keywish/keywish-hummer-bot-v2.0/README.md

# Please Contact Us
Technical support email: support@keywish-robot.com</br>
Sales email: ken@keywish-robot.com</br>
The latest information download address:https://github.com/keywish/keywish-hummer-bot-v2.0    </br>


# Hummer-bot 
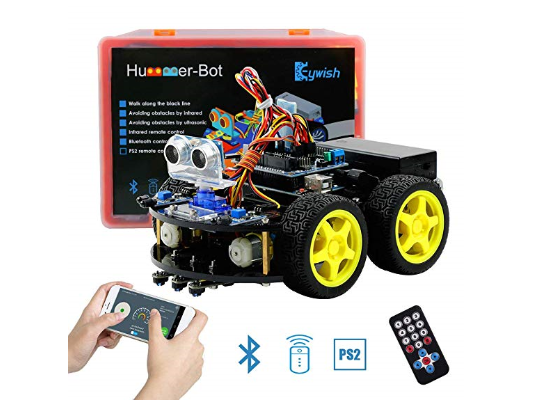
[picture p1: hummer_bot2.0.jpg]


# Introduction
Hummer-Bot is a multi-function car, it is based on the Arduino UNO and the L298N motor drive module. You can freely install various sensor modules such as servo, ultrasonic, infrared obstacle avoidance, infrared tracking, etc. It can trace and avoid obstacles automatically, and it supports multiple remote control methods: infrared remote control, Bluetooth APP, PS2 handle (optional). And we will provide CD with the best tutorial including the programs and codes which bring you to the robot car world. It is the best choice for electronics enthusiasts, makers, and Arduino enthusiasts.
# Feature
* 3-channel infrared tracking modules </br>
* 2 sets of infrared obstacle avoidance modules </br>
* ultrasonic obstacle avoidance with servo </br>
* 2-channel DC motor drive </br>
* 2 rechargeable lithium batteries:3000mZh/3.7v, longer battery life </br>
* Real-time battery power detection </br>
* Infrared remote control </br>
* Bluetooth app control </br>
* PS2 handle control (optional) </br>

# Required Best Buy Links
[Buy on Amazon]( https://www.amazon.com/dp/B07CFX53W4) </br>
[Buy on AliExpress]( https://www.aliexpress.com/store/product/Smart-Cars-for-Arduino-UNO-R3-Super-Starter-Kit-APP-RC-Remote-Control-Ultrasonic-Bluetooth-Module/3269016_32920074010.html)

# Download Method
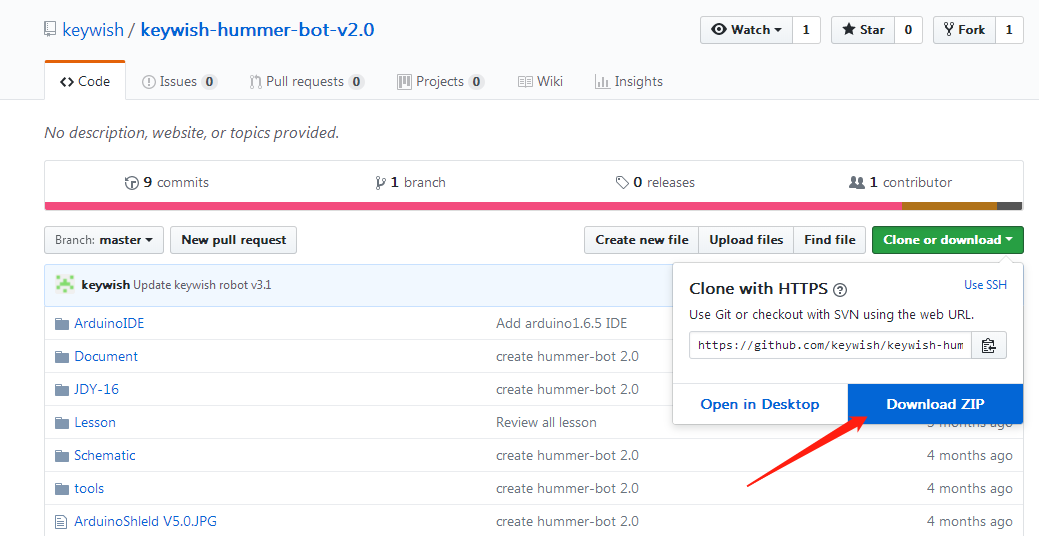
[picture p2: Download_instructions.jpg]
