keywish/keywish-hummer-bot-v2.0/Lesson/ModuleDemo/UltrasonicDemo/Ultrasonic.pdf

## Ultrasonic

## Ultrasonic ranging principle

Ultrasonic transmitter launches ultrasonic to a certain direction and we start timing at the same time. When the ultrasonic in the air runs into obstacles, it will return immediately, ultrasonic receiver receives the reflected wave, then we stop timing. Sound waves in the air are at the rate of 340 m/s, according to the recorded time t, the distance s between launch spot and the obstacles can be calculated, that is: s = 340m / s * t / 2. So we can get the distance.
Ultrasonic ranging module has four pins, they are Vcc, Trig, Echo, GND, among the Trig is distance measuring trigger pin, as long as the Trig pin are at least 10μs high level, ultrasonic sending module will automatically send eight 40KHZ ultrasonic pulse, and automatically detect whether there is a returned signal . This step will be done automatically by the inside module. If there is any returned signal, the Echo pin will output high level, the duration of the high level is the time of ultrasonic wave from launch to return. At this point, we can use pulseIn () function to obtain the result of distance measuring, and calculate the actual distance.

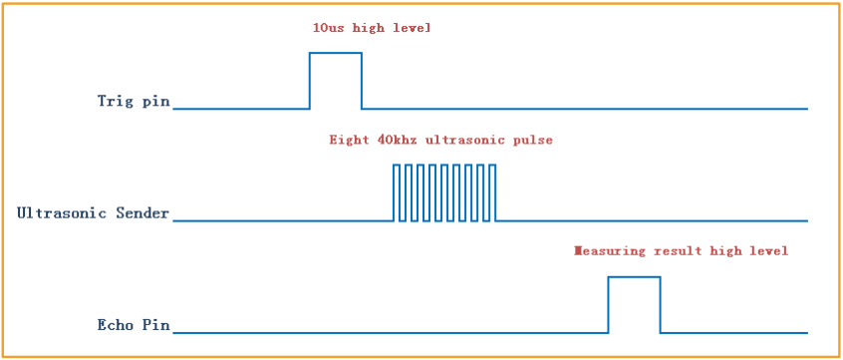
[picture p3: figure]

## Experiment Purpose

The purpose is to type ultrasonic ranging module distance through a serial port.

## Component List

- Keywish Arduino UNO R3 mainboard
- Breadboard
- USB cable
- Ultrasonic module* 1
- Several jumper wires

## Wiring of Circuit

Arduino Uno | Ultrasonic
VCC | 1Vcc)
2 | 2 (Trig)
3 | 3(Echo)
GND | 4 (Gnd)

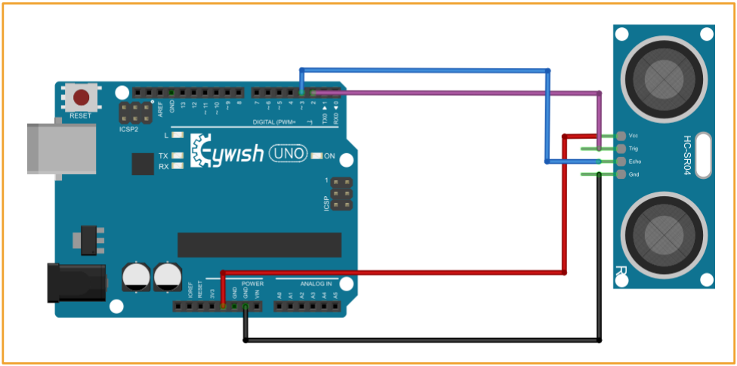
[picture p4: figure]

## Code

const int TrigPin = 2;
const int EchoPin = 3;
float cm;
void setup()
{
Serial.begin(115200);
pinMode(TrigPin, OUTPUT);
pinMode(EchoPin, INPUT);
pinMode(8,OUTPUT);
}
void loop()
{
digitalWrite(8, LOW);
digitalWrite(TrigPin, LOW); //Send low level to TrigPin

delayMicroseconds(2);
digitalWrite(TrigPin, HIGH);//Send high level to TrigPin
delayMicroseconds(10); | //hold 10us

digitalWrite(TrigPin, LOW);
cm = pulseIn(EchoPin, HIGH) / 58.0;
cm = (int(cm * 100.0)) / 100.0;
if (cm>=2 && cm<=10)
digitalWrite(8, HIGH);
}

## Experiment Result

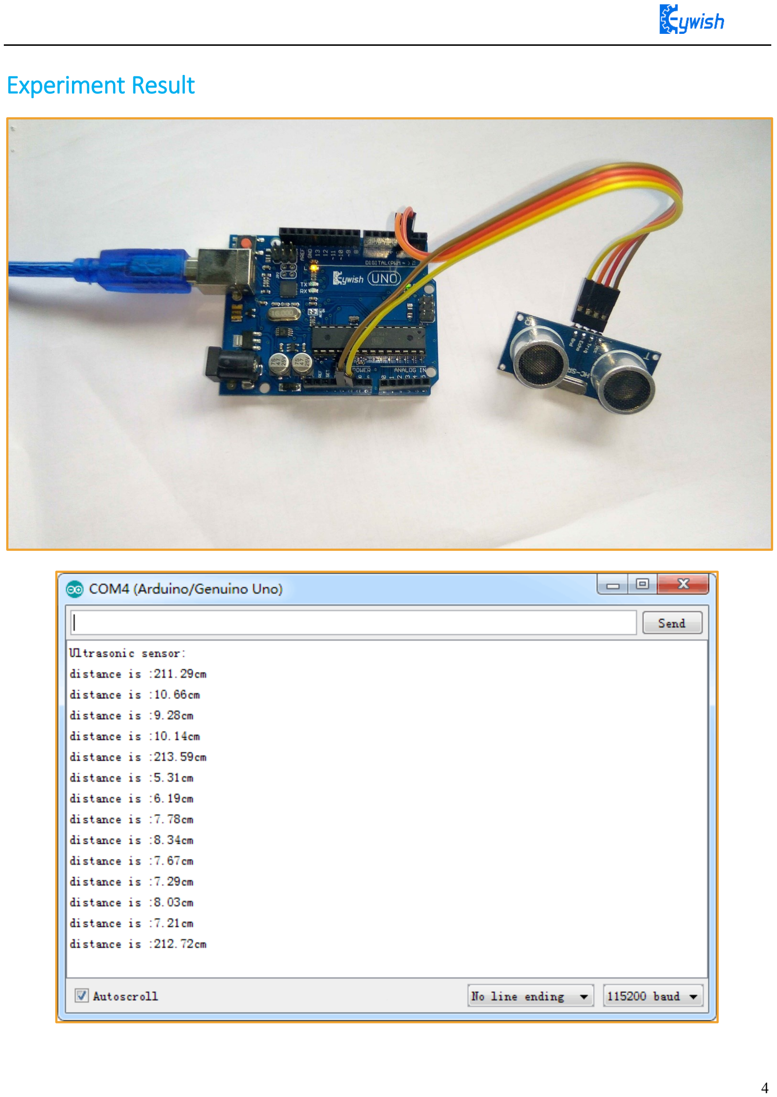
[picture p5: page 4]
