keywish/keywish-hummer-bot-v2.0/Scratch/Hummer-Bot_Mixly/Hummer-Bot_Mixly/media/hummerbot/hb_irremote.jpg

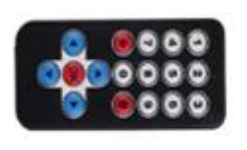
Scratch/Hummer-Bot_Mixly/Hummer-Bot_Mixly/media/hummerbot/hb_irremote.jpg
