keywish/keywish-hummer-bot-v2.0/Lesson/Advanced Experiment/Hummerbot_Ultrasound/UltrasonicAvoidance.pdf

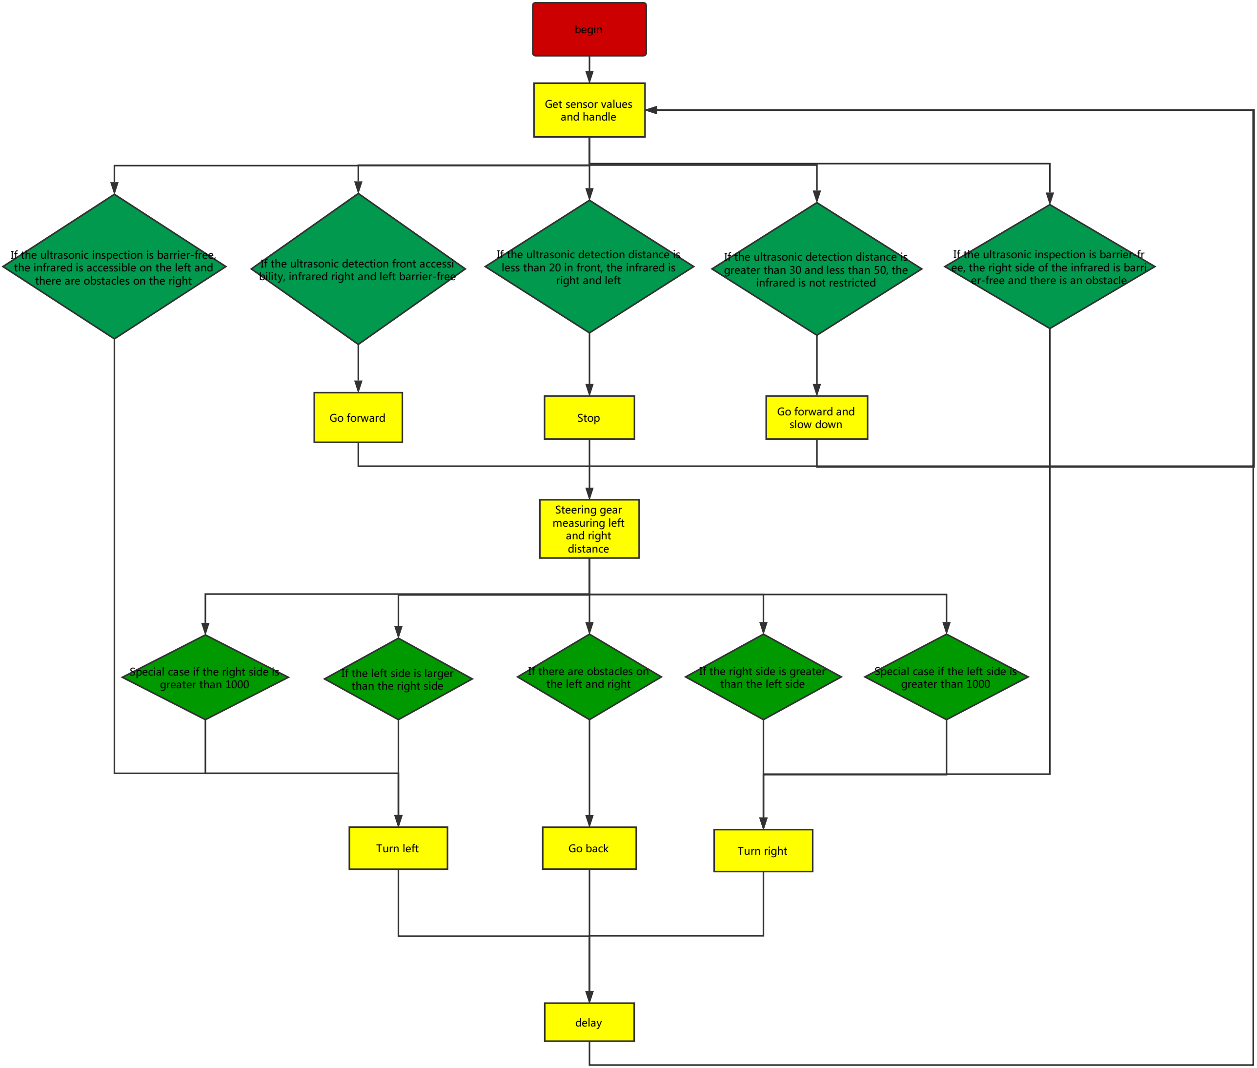
[picture p157: figure]
begin; Get sensor values and handle; Go forward; If the ultrasonic detection distance is greater than 30 and less than 50, the infrared is not restricted; Go forward and slow down; there are obstacles on the right; er-free and there is an obstacle; If the ultrasonic detection distance is less than 20 in front, the infrared is right and left; Stop; Steering gear measuring left and right distance; If there are obstacles on the left and right; Go back; If the left side is larger than the right side; Turn left; If the right side is greater than the left side; Turn right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

If the ultrasonic detection front accessi bility, infrared right and left barrier-free

If the ultrasonic inspection is barrier-free, the infrared is accessible on the left and

If the ultrasonic inspection is barrier-fr ee, the right side of the infrared is barri
