keywish/keywish-hummer-bot-v2.0/(threads)

Thread 1 (2019-04-13):

Code Broken

presider, 2019-04-13:
codes not work...

schnapper79, 2019-05-15:
I tried to use the scratch library (mblock) from this repository.

Problem 1)  JSON in Zip-Archive (Hummerbot.s2e - File)  is invalid and broken
after fixing the JSON - Errors I was able to include it into my mblock - installation.

Problem 2) Invalid code is generated:  For example the Block "hummerbot Programm" adds an #include "KeyMap.h" - line which looks good at first glance.  Only failure: the File is called "Keymap.h".

Oh, btw... For whatever reason mblock can't compile directly for Arduino as it says: "no sketch file found at  this place".   But you can open Arduino-IDE from mblock and you can edit your code there. Great.

Except Arduino IDE doesn't find the libraries...  but I am not sure if that's a Problem with YOUR code or with mblock.

After I made an own Arduino - Library with the libraries from your ZIP File and fixing all filenames and JSON I was able to get the code compiled.

I was NOT able to test the hummerbot itself yet as I was busy fixing YOUR stuff

For a lifetime supply of Hummerbots and other stuff i might share my code with you to fix this repository :smiling_imp:

vladvvl514, 2024-02-12:
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

Что именно нужно сделать чтобы все работало?
