keywish/keywish-hummer-bot-v2.0/Lesson/Comprehensive Experiment/Hummerbot_InfraredTracing/InfraredTracing.pdf

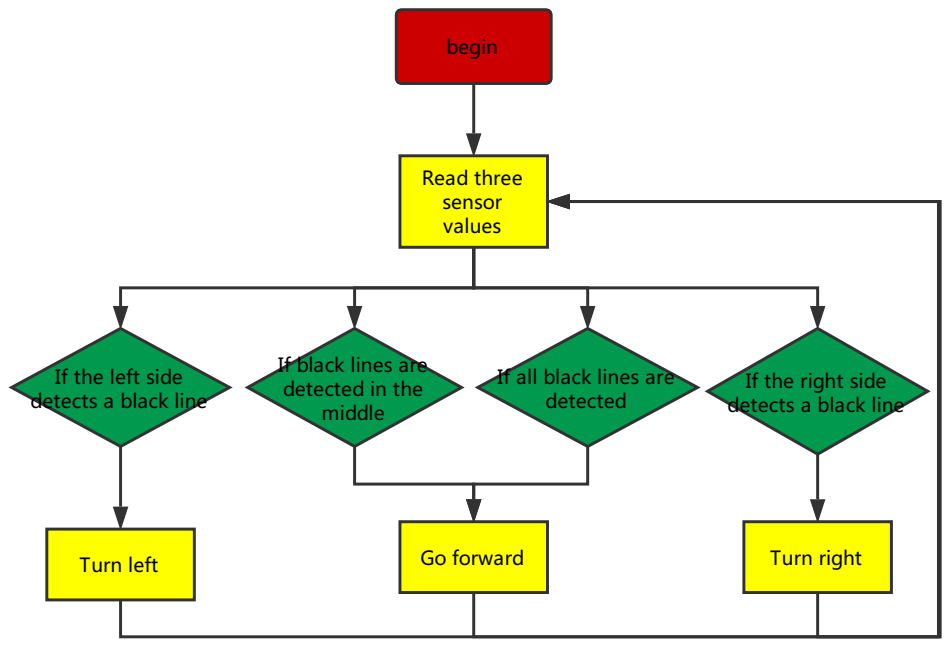
[picture p158: page 1]
begin; Read three sensor values; Go forward; Turn right; Turn left

If black lines are
detected in the
middle

If the left side
detects a black line

If all black lines are
detected

If the right side
