keywish/keywish-hummer-bot-v2.0/Lesson/Comprehensive Experiment/Hummerbot_IR/Infrared remote control.pdf

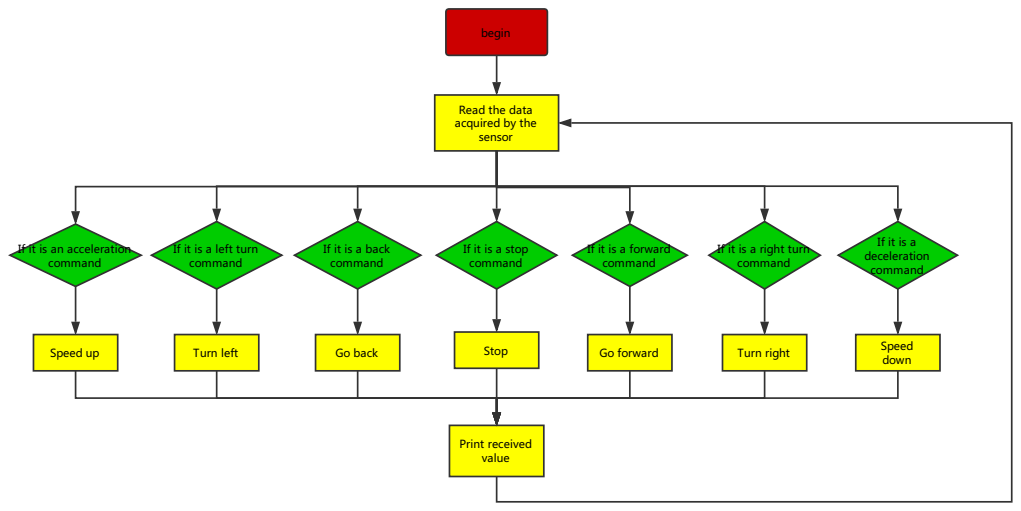
[picture p159: page 1]
begin; Go forward; Go back; Turn left; Turn right; Stop; Speed up; Speed down; Print received value

Read the data
acquired by the
sensor

If it is an acceleration
command

If it is a left turn

If it is a back

If it is a stop

If it is a forward

If it is a right turn

deceleration
