keywish/keywish-hummer-bot-v2.0/Schematic/Infrared obstacle avoidance.pdf

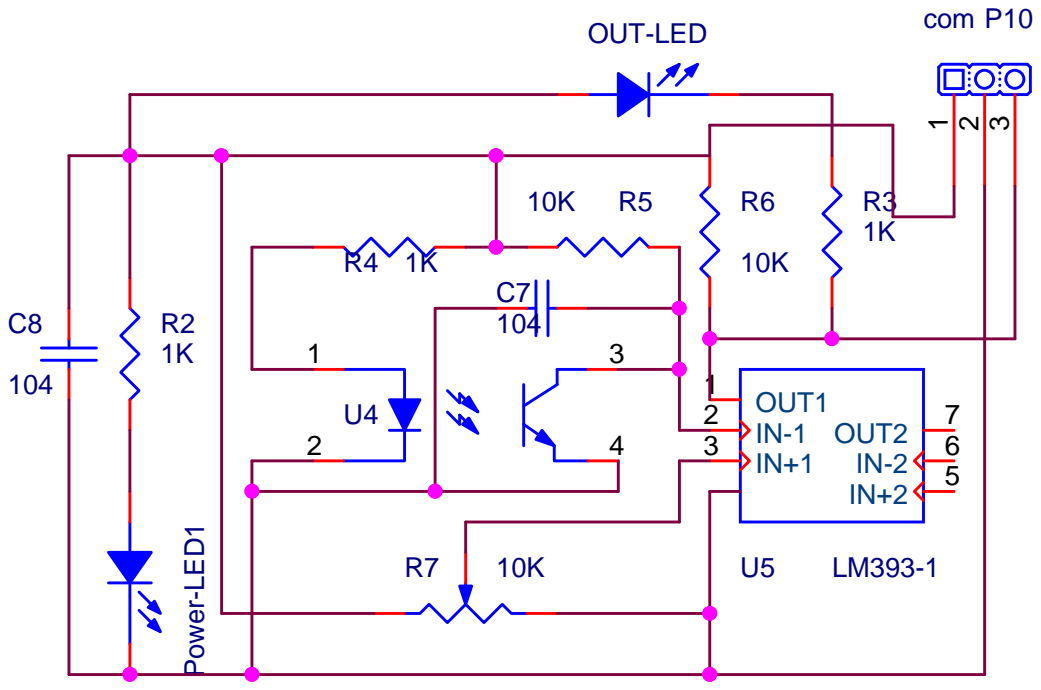
[picture p160: page 1]

Size Size Size A A A | Document Number Document Number Document Number | Rev Rev Rev

Date: Date: Date: Wednesday, September 20, 2017 Wednesday, September 20, 2017 Wednesday, September 20, 2017 | Sheet Sheet Sheet 1 1 1 of of of 1 1 1
