keywish/keywish-hummer-bot-v2.0/Schematic/L298N_Module.pdf

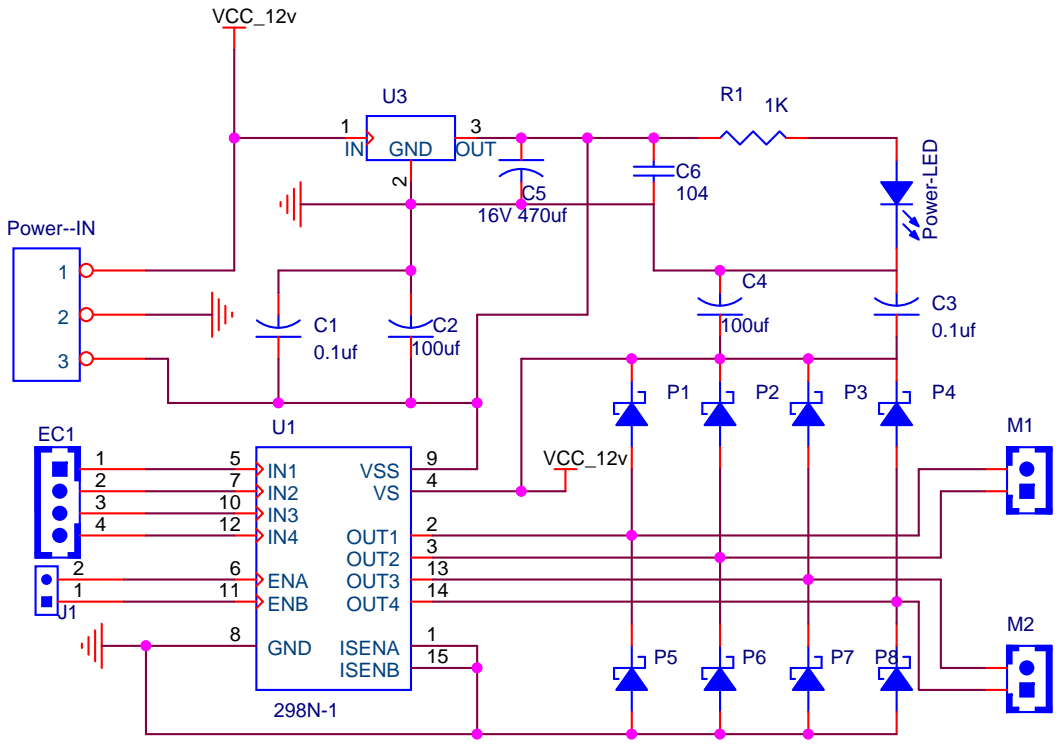
[picture p161: page 1]
