keywish/keywish-hummer-bot-v2.0/Schematic/Ultrasonic.pdf

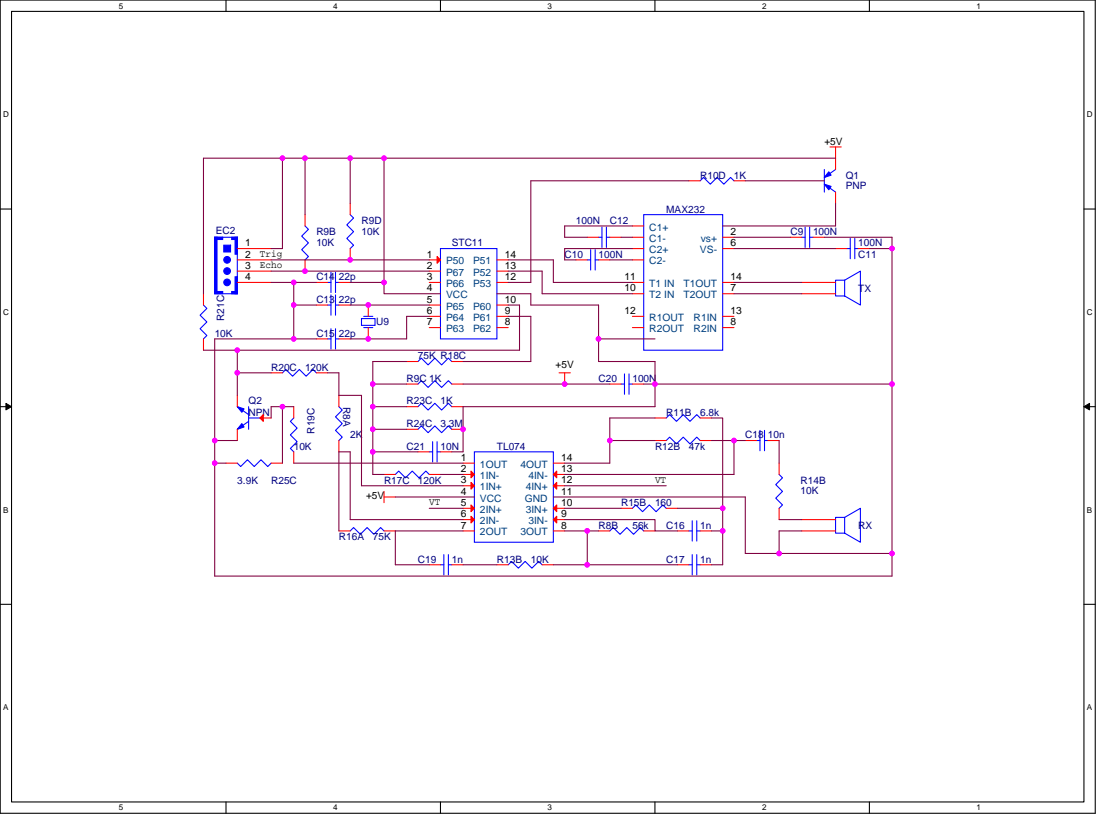
[picture p162: page 1]
