keywish/keywish-hummer-bot-v2.0/Lesson/Advanced Experiment/Hummerbot_InfraredAvoidance/InfraredAvoidance.pdf

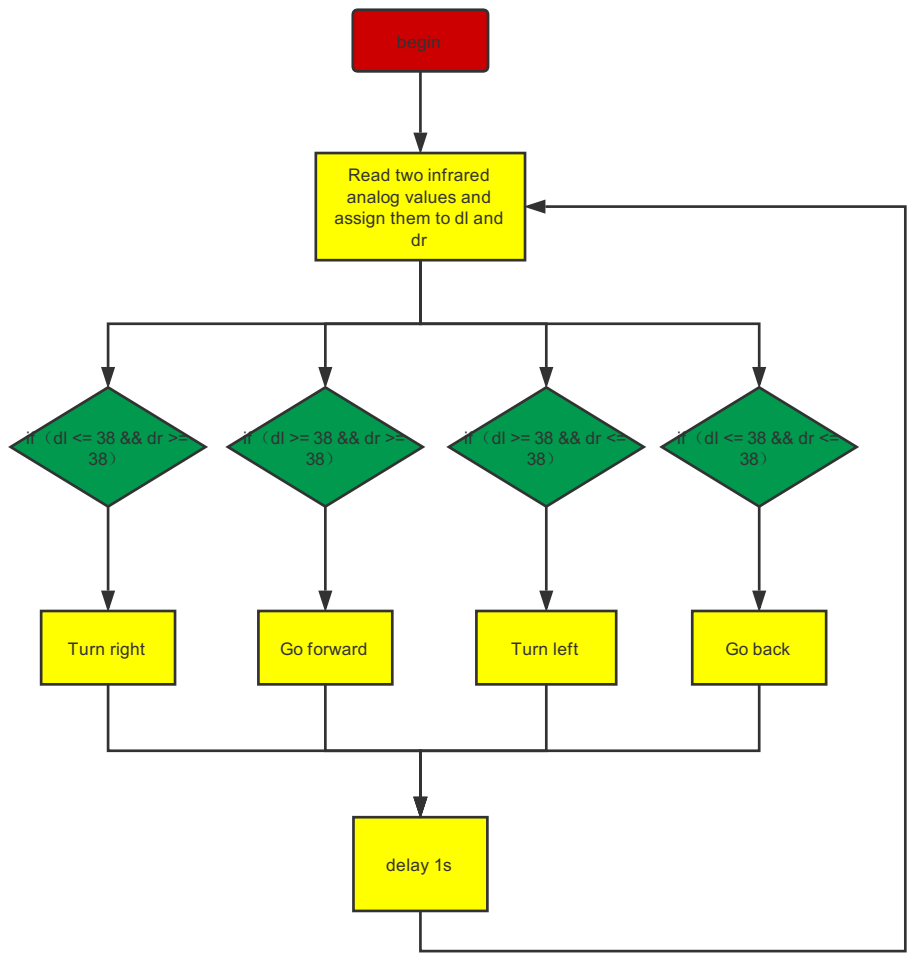
[picture p163: page 1]
begin; Turn left; Go back; Turn right; Go forward; delay 1s

Read two infrared
analog values and
assign them to dl and
