keywish/keywish-hummer-bot-v2.0/Lesson/Comprehensive Experiment/Hummerbot_Bluetooth/Bluetooth.pdf

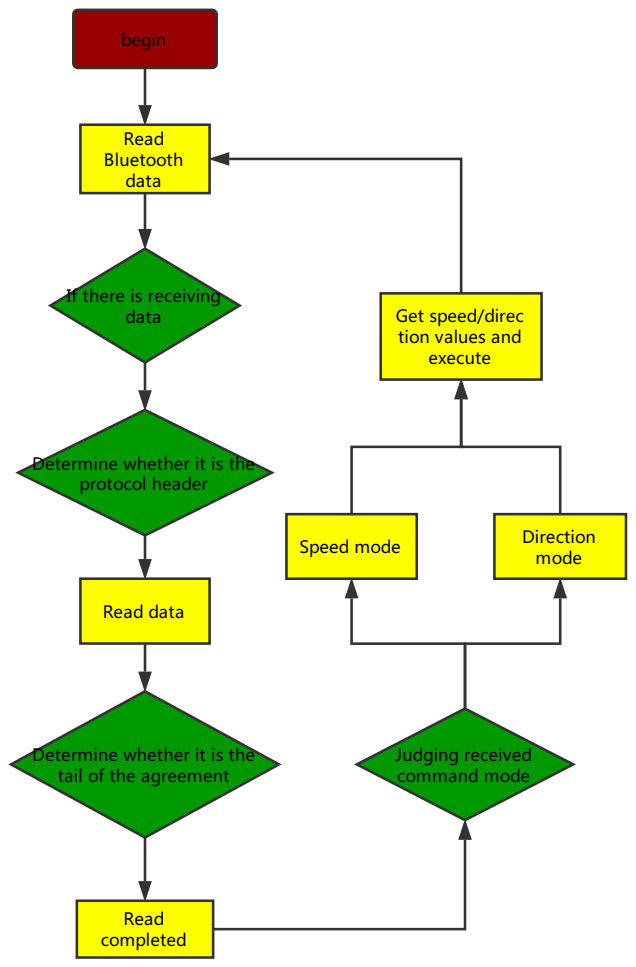
[picture p164: page 1]
begin; Read Bluetooth data; Read data; Read completed; Speed mode; Direction mode; Judging received command mode

If there is receiving
data

Get speed/direc
tion values and
execute

Determine whether it is the
protocol header

tail of the agreement
