keywish/keywish-hummer-bot-v2.0/Scratch/Hummer-Bot_Mixly/Hummer-Bot_Mixly/hummerbot/InfraredAvoidance.cpp

#include "InfraredAvoidance.h"

uint8_t Left, Right;

InfraredAvoidance::InfraredAvoidance(byte pin1, byte pin2)
{
  InfraredAvoidancePin1 = pin1;
  InfraredAvoidancePin2 = pin2;
  pinMode(InfraredAvoidancePin1, INPUT);
  pinMode(InfraredAvoidancePin2, INPUT);

}
uint8_t InfraredAvoidance ::GetInfraredAvoidanceLeftValue()
{
  Left = analogRead(InfraredAvoidancePin2);
  return Left;
}


uint8_t InfraredAvoidance :: GetInfraredAvoidanceRightValue()
{
  Right = analogRead(InfraredAvoidancePin1);
  return Right;
}
