keywish/keywish-hummer-bot-v2.0/Scratch/Hummer-Bot_Mixly/Hummer-Bot_Mixly/hummerbot/InfraredAvoidance.h

#ifndef _INFRAREDAVOIDABCE_H_
#define _INFRAREDAVOIDABCE_H_
#define IA_THRESHOLD 40

/* Includes ------------------------------------------------------------------*/
#include <Arduino.h>

class InfraredAvoidance
{
  private:
    byte InfraredAvoidancePin1, InfraredAvoidancePin2;

  public:
    InfraredAvoidance(byte pin1, byte pin2);
    uint8_t GetInfraredAvoidanceLeftValue();
    uint8_t GetInfraredAvoidanceRightValue();
};
#endif
