keywish/keywish-hummer-bot-v2.0/Scratch/Hummer-Bot_Mixly/Hummer-Bot_Mixly/hummerbot/InfraredTracing.h

#ifndef _INFRAREDTRACING_H_
#define _INFRAREDTRACING_H_

/* Includes ------------------------------------------------------------------*/
#include <stdint.h>
#include <stdbool.h>
#include <Arduino.h>

#ifndef __AVR_ATmega32U4__

#define IT_USECPERTICK 100  // microseconds per clock interrupt tick

#ifdef F_CPU
#define IT_SYSCLOCK F_CPU     // main Arduino clock
#else
#define IT_SYSCLOCK 16000000  // main Arduino clock
#endif

#define IT_TIMER_DISABLE_INTR   (TIMSK2 = 0)
#define IT_TIMER_ENABLE_PWM     (TCCR2A |= _BV(COM2B1))
#define IT_TIMER_DISABLE_PWM    (TCCR2A &= ~(_BV(COM2B1)))
#define IT_TIMER_ENABLE_INTR    (TIMSK2 = _BV(OCIE2A))
#define IT_TIMER_DISABLE_INTR   (TIMSK2 = 0)
#define IT_TIMER_INTR_NAME      TIMER2_COMPA_vect
#define IT_TIMER_CONFIG_KHZ(val) ({ \
  const uint8_t pwmval = F_CPU / 2000 / (val); \
  TCCR2A = _BV(WGM20); \
  TCCR2B = _BV(WGM22) | _BV(CS20); \
  OCR2A = pwmval; \
  OCR2B = pwmval / 3; \
})

#define IT_TIMER_COUNT_TOP      (IT_SYSCLOCK * IT_USECPERTICK / 1000000)
#if (IT_TIMER_COUNT_TOP < 256)
#define IT_TIMER_CONFIG_NORMAL() ({ \
  TCCR2A = _BV(WGM21); \
  TCCR2B = _BV(CS20); \
  OCR2A = IT_TIMER_COUNT_TOP; \
  TCNT2 = 0; \
})
#else
#define IT_TIMER_CONFIG_NORMAL() ({ \
  TCCR2A = _BV(WGM21); \
  TCCR2B = _BV(CS21); \
  OCR2A = IT_TIMER_COUNT_TOP / 8; \
  TCNT2 = 0; \
})
#endif

#endif // !__AVR_ATmega32U4__

#define  IT_ALL_BLACK     0b000
#define  IT_ALL_WHITE     0b111
#define  IT_LEFT1         0b011
#define  IT_LEFT2         0b001
#define  IT_CENTER        0b101
#define  IT_RIGHT1        0b110
#define  IT_RIGHT2        0b100


// information for the interrupt handler
typedef enum {
	E_INFRARED_SENSOR_2,
    E_INFRARED_SENSOR_3,
	E_INFRARED_SENSOR_4,
	E_INFRARED_SENSOR_5
} E_INFRARWD_TRACING_MODE;


class InfraredTracing
{
private:
	byte InfraredTracingPin1, InfraredTracingPin2, InfraredTracingPin3, InfraredTracingPin4, InfraredTracingPin5;
	byte value;
	double irDelayTime;

public:
	InfraredTracing(byte pin1, byte pin2);
	InfraredTracing(byte pin1, byte pin2, byte pin3);
	InfraredTracing(byte pin1, byte pin2, byte pin3, byte pin4);
	InfraredTracing(byte pin1, byte pin2, byte pin3, byte pin4, byte pin5);
	void begin();
	void end();
	boolean CheckBlack();
	E_INFRARWD_TRACING_MODE InfraredTracingMode;
	byte getValue(void);
};
#endif
