keywish/keywish-hummer-bot-v2.0/(commit log)

2018-08-12 Add arduino1.6.5 IDE
2018-08-22 Review all lesson
    1.Fix ultrasonic bug
    2.Fix infrared tracing bug
    [Hummerbot.cpp, Hummerbot.h, Hummerbot_Bluetooth.ino, Hummerbot_IR.ino, Hummerbot_InfraredAvoidanceAndUltrasonicAvoidance.ino, Hummerbot_Ultrasound.ino, InfraredAvoidance.cpp, InfraredAvoidance.h]
2018-11-12 Fix pin conflict
2019-01-03 Update instruction manual for update componet list
    1.modify compont list
    2.fix arduino ide1.65 build error
    [Buletooth.ino, Hummer-bot.ino, Hummerbot.cpp, Hummerbot.h, Hummerbot_Bluetooth.ino, Hummerbot_IR.ino, Hummerbot_InfraredAvoidanceAndUltrasonicAvoidance.ino, Hummerbot_Ultrasound.ino]
2019-01-28 change the Infrared tracing Bug
    [InfraredTracing.ino]
2019-03-11 update the app and the motor test demo
2019-03-15 update the ultrasonic demo
2019-03-28 add the ARDUINO IDE Driver
2019-04-16 update the ps2 Program and the ultrasonic avoidance
    [PS2X_lib.h, Servo_test.cpp, Servo_test.h, UltrasonicAvoidance.ino]
2019-05-20 delect the driver folder
